rscarson14/CaRe-Monitor/README.md

CaRe-Monitor
============

Resource repository for Infant Cardiac Respiratory Monitor - CaRe Monitor
