rscarson14/CaRe-Monitor/CaRe Electrical Design/Bill of Materials/CaReBOM_DIGIKEY_6.29.xls

Digi-Key Part Number | Manufacturer | Manufacturer Part Number | Customer Reference | Quantity 1 | Quantity 2 | Quantity 3 | Mfg Std Lead Time | Description | Comments | RoHS Status | Lead Free Status | REACH Status
XC1925-ND | ECS INC | ECS-160-20-4X-DU | Y1 | 1 | 0 | 0 | 9 Weeks | CRYSTAL 16MHZ 20PF THRU |  | RoHS Compliant | Lead free | Not Available
MF-MSMF050-2CT-ND | BOURNS INC (VA) | MF-MSMF050-2 | F1 | 1 | 0 | 0 | 9 Weeks | PTC RESETTABLE .50A 15V 1812 | Alternate Packaging Exists | RoHS Compliant | Lead free | Unaffected Dec-2013
296-11981-1-ND | TEXAS INSTRUMENTS (VA) | TLV274IDR | U1, U3 | 2 | 0 | 0 | 7 Weeks | IC OPAMP GP 3MHZ RRO 14SOIC | Alternate Packaging Exists | RoHS Compliant | Lead free | Unaffected Jun-2012
X9C503SIZ-ND | INTERSIL | X9C503SIZ | U2 | 1 | 0 | 0 | 7 Weeks | IC XDCP 100-TAP 50K EE 8-SOIC | Alternate Packaging Exists | RoHS Compliant | Lead free | Unaffected Jun-2012
LT1920CS8#PBF-ND | LINEAR TECHNOLOGY | LT1920CS8#PBF | U5 | 1 | 0 | 0 | 4 Weeks | IC OPAMP INSTR 1MHZ 8SO | Alternate Packaging Exists | RoHS Compliant | Lead free | Unaffected Dec-2013
ATMEGA328-PU-ND | ATMEL | ATMEGA328-PU | U6 | 1 | 0 | 0 | 6 Weeks | IC MCU 8BIT 32KB FLASH 28DIP | No delivery date available | RoHS Compliant | Lead free | Unaffected Jun-2013
MCP73831T-2ACI/OTCT-ND | MICROCHIP TECHNOLOGY (VA) | MCP73831T-2ACI/OT | U7 | 1 | 0 | 0 | 14 Weeks | IC CONTROLLR LI-ION 4.2V SOT23-5 | Alternate Packaging Exists | RoHS Compliant | Lead free | Unaffected Dec-2013
296-27017-1-ND | TEXAS INSTRUMENTS (VA) | TPS61200DRCR | U8 | 1 | 0 | 0 | 11 Weeks | IC REG BOOST SYNC ADJ 1.2A 10SON | Alternate Packaging Exists | RoHS Compliant | Lead free | Unaffected Jun-2012
768-1007-1-ND | FTDI (VA) | FT232RL-REEL | U9 | 1 | 0 | 0 | 10 Weeks | IC USB FS SERIAL UART 28-SSOP | Alternate Packaging Exists | RoHS Compliant | Lead free | Unaffected Jun-2011
160-1427-1-ND | LITE-ON INC (VA) | LTST-C171KRKT | DS1 | 1 | 0 | 0 | 8-10 Weeks | LED SUPER RED CLR THIN 0805 SMD | Alternate Packaging Exists | RoHS Compliant | Lead free | Not Available
LM4040EIM3-2.5/NOPBCT-ND | TEXAS INSTRUMENTS (VA) | LM4040EIM3-2.5/NOPB | U4 | 1 | 0 | 0 | 9 Weeks | IC VREF SHUNT 2.5V SOT23-3 | Alternate Packaging Exists | RoHS Compliant | Lead free | Unaffected Jun-2012
BAT42XV2CT-ND | FAIRCHILD SEMICONDUCTOR (VA) | BAT42XV2 | D1, D2, D3 | 3 | 0 | 0 | 11 Weeks | DIODE SCHOTTKY 30V 0.2A SOD523F | Alternate Packaging Exists | RoHS Compliant | Lead free | Unaffected Jun-2011
GH7268-ND | GRAYHILL INC | 30-100 | S1(MONITOR_EN) | 1 | 0 | 0 | 8 Weeks | SWITCH PUSH SPST-NO 0.15A 24V |  | RoHS Compliant | Lead free | Unaffected Jun-2012
CP-2940-ND | CUI INC | MD-40PL100 | BOX DIN RECEPTACLE, GARMENT DIN RECEPTACLE | 2 | 0 | 0 | 14 Weeks | CONN MINI DIN RECPT 4P PNL MT |  | RoHS Compliant | Lead free | Unaffected Oct-2010
MUSBB15134-ND | AMPHENOL COMMERCIAL PRODUCTS | MUSBB15134 | MINI USB B RECEPTACLE | 1 | 0 | 0 | 6 Weeks | CONN RUGGED USB RCPT R/A MINI B |  | RoHS Compliant | Lead free | Unaffected Nov-2011
SRA27G-ND | SERPAC | A27,GY | BOX | 1 | 0 | 0 | 2 Weeks | BOX A SERIES GRY (3.35X5.3X1.5) |  | RoHS Compliant | Lead free | Unaffected Oct-2011
EG1859-ND | E-SWITCH | R1966ABLKBLKESGRN | SW2 | 1 | 0 | 0 | 12 Weeks | SWITCH ROCKER SPST 15A 125V |  | RoHS Compliant | Lead free | Unaffected Jun-2012
RNCP0805FTD499RCT-ND | STACKPOLE ELECTRONICS INC (VA) | RNCP0805FTD499R | R4 | 1 | 0 | 0 | 10 Weeks | RES 499 OHM 1/4W 1% 0805 | Alternate Packaging Exists | RoHS Compliant | Lead free | Unaffected Aug-2011
RMCF0805FT560KCT-ND | STACKPOLE ELECTRONICS INC (VA) | RMCF0805FT560K | R8 | 1 | 0 | 0 | 9 Weeks | RES 560K OHM 1/8W 1% 0805 | Alternate Packaging Exists | RoHS Compliant | Lead free | Unaffected Aug-2011
RMCF0805FT15K0CT-ND | STACKPOLE ELECTRONICS INC (VA) | RMCF0805FT15K0 | R14 | 1 | 0 | 0 | 9 Weeks | RES 15K OHM 1/8W 1% 0805 | Alternate Packaging Exists | RoHS Compliant | Lead free | Unaffected Aug-2011
311-2.20KCRCT-ND | YAGEO (VA) | RC0805FR-072K2L | R3 | 1 | 0 | 0 | 17 Weeks | RES 2.2K OHM 1/8W 1% 0805 SMD | Alternate Packaging Exists | RoHS Compliant | Lead free | Unaffected Sep-2011
RMCF0805FT2K70CT-ND | STACKPOLE ELECTRONICS INC (VA) | RMCF0805FT2K70 | R1 | 1 | 0 | 0 | 9 Weeks | RES 2.7K OHM 1/8W 1% 0805 | Alternate Packaging Exists | RoHS Compliant | Lead free | Unaffected Aug-2011
RMCF0805FT24K0CT-ND | STACKPOLE ELECTRONICS INC (VA) | RMCF0805FT24K0 | R5 | 1 | 0 | 0 | 9 Weeks | RES 24K OHM 1/8W 1% 0805 | Alternate Packaging Exists | RoHS Compliant | Lead free | Unaffected Aug-2011
RMCF0805FT27K0CT-ND | STACKPOLE ELECTRONICS INC (VA) | RMCF0805FT27K0 | R6 | 1 | 0 | 0 | 9 Weeks | RES 27K OHM 1/8W 1% 0805 | Alternate Packaging Exists | RoHS Compliant | Lead free | Unaffected Aug-2011
RMCF0805FT2K00CT-ND | STACKPOLE ELECTRONICS INC (VA) | RMCF0805FT2K00 | R17 | 1 | 0 | 0 | 9 Weeks | RES 2K OHM 1/8W 1% 0805 | Alternate Packaging Exists | RoHS Compliant | Lead free | Unaffected Aug-2011
RMCF0805FT374KCT-ND | STACKPOLE ELECTRONICS INC (VA) | RMCF0805FT374K | R13 | 1 | 0 | 0 | 9 Weeks | RES 374K OHM 1/8W 1% 0805 | Alternate Packaging Exists | RoHS Compliant | Lead free | Unaffected Aug-2011
RMCF0805FT2M00CT-ND | STACKPOLE ELECTRONICS INC (VA) | RMCF0805FT2M00 | R18, R19 | 2 | 0 | 0 | 9 Weeks | RES 2M OHM 1/8W 1% 0805 | Alternate Packaging Exists | RoHS Compliant | Lead free | Unaffected Aug-2011
311-470CRCT-ND | YAGEO (VA) | RC0805FR-07470RL | R16, R22, R26 | 3 | 0 | 0 | 17 Weeks | RES 470 OHM 1/8W 1% 0805 SMD | Alternate Packaging Exists | RoHS Compliant | Lead free | Unaffected Sep-2011
RMCF0805FT560RCT-ND | STACKPOLE ELECTRONICS INC (VA) | RMCF0805FT560R | R7, R9, R12 | 3 | 0 | 0 | 9 Weeks | RES 560 OHM 1/8W 1% 0805 | Alternate Packaging Exists | RoHS Compliant | Lead free | Unaffected Aug-2011
RMCF0805FT220KCT-ND | STACKPOLE ELECTRONICS INC (VA) | RMCF0805FT220K | R10, R11, G20, R21 | 4 | 0 | 0 | 9 Weeks | RES 220K OHM 1/8W 1% 0805 | Alternate Packaging Exists | RoHS Compliant | Lead free | Unaffected Aug-2011
RMCF0805FT10K0CT-ND | STACKPOLE ELECTRONICS INC (VA) | RMCF0805FT10K0 | R2, R15, R23, R24, R25 | 5 | 0 | 0 | 9 Weeks | RES 10K OHM 1/8W 1% 0805 | Alternate Packaging Exists | RoHS Compliant | Lead free | Unaffected Aug-2011
445-7665-1-ND | TDK CORPORATION (VA) | C2012X5R1A226M125AB | C24 | 1 | 0 | 0 | 12 Weeks | CAP CER 22UF 10V 20% X5R 0805 | Alternate Packaging Exists | RoHS Compliant | Lead free | Unaffected Apr-2011
720-1074-1-ND | VISHAY VITRAMON (VA) | VJ0805A470JXGAT5Z | C3 | 1 | 0 | 0 | 12 Weeks | CAP CER 47PF 1KV 5% NP0 0805 | Alternate Packaging Exists | RoHS Compliant | Lead free | Unaffected Dec-2011
399-1113-1-ND | KEMET (VA) | C0805C220J5GACTU | C15, C19 | 2 | 0 | 0 | 16 Weeks | CAP CER 22PF 50V 5% NP0 0805 | Alternate Packaging Exists | RoHS Compliant | Lead free | Unaffected Jun-2012
490-4522-1-ND | MURATA ELECTRONICS (VA) | GRM21BR71C475KA73L | C14, C17 | 2 | 0 | 0 | 18 Weeks | CAP CER 4.7UF 16V 10% X7R 0805 | Alternate Packaging Exists | RoHS Compliant | Lead free | Unaffected Jul-2011
490-5523-1-ND | MURATA ELECTRONICS (VA) | GRM21BR61E106KA73L | C6, C7, C11 | 3 | 0 | 0 | 18 Weeks | CAP CER 10UF 25V 10% X5R 0805 | Alternate Packaging Exists | RoHS Compliant | Lead free | Unaffected Jul-2011
478-3281-1-ND | AVX CORPORATION (VA) | TAJP106M010RNJ | C9, C13, C16, C22, C23 | 5 | 0 | 0 | 13 Weeks | CAP TANT 10UF 10V 20% 0805 | Alternate Packaging Exists | RoHS Compliant | Lead free | Unaffected Jun-2012
490-1664-1-ND | MURATA ELECTRONICS (VA) | GRM216R71H103KA01D | C1, C2, C5, C10 | 4 | 0 | 0 | 18 Weeks | CAP CER 10000PF 50V 10% X7R 0805 | Alternate Packaging Exists | RoHS Compliant | Lead free | Unaffected Jul-2011
478-1395-1-ND | AVX CORPORATION (VA) | 08055C104KAT2A | C4, C8, C12, C18, C20, C21, C25 | 7 | 0 | 0 | 13 Weeks | CAP CER 0.1UF 50V 10% X7R 0805 | No delivery date available | RoHS Compliant | Lead free | Unaffected Jun-2012
308-1947-1-ND | SUMIDA AMERICA COMPONENTS INC (VA) | CDRH2D09NP-4R7MC | L1 | 1 | 0 | 0 | 13 Weeks | INDUCTOR 4.7UH 25% SMD | Alternate Packaging Exists | RoHS Compliant | Lead free | Not Available
NDS0605CT-ND | FAIRCHILD SEMICONDUCTOR (VA) | NDS0605 | Q1 | 1 | 0 | 0 | 7 Weeks | MOSFET P-CH 60V 180MA SOT-23 | Alternate Packaging Exists | RoHS Compliant | Lead free | Unaffected Jun-2011
455-1790-1-ND | JST SALES AMERICA INC (VA) | BM04B-SRSS-TB(LF)(SN) | P2(USB), P6(ELECTRODES) | 2 | 0 | 0 | 12-14 Weeks | CONN HEADER SH 4POS TOP 1MM TIN | Alternate Packaging Exists | RoHS Compliant | Lead free | N/A
455-1793-1-ND | JST SALES AMERICA INC (VA) | BM07B-SRSS-TB(LF)(SN) | P7(FRNT_PNL) | 1 | 0 | 0 | 12-14 Weeks | CONN HEADER SH 7POS TOP 1MM TIN | Alternate Packaging Exists | RoHS Compliant | Lead free | N/A
455-1791-1-ND | JST SALES AMERICA INC (VA) | BM05B-SRSS-TB(LF)(SN) | P5(TOP_PNL) | 1 | 0 | 0 | 12-14 Weeks | CONN HEADER SH 5POS TOP 1MM TIN | Alternate Packaging Exists | RoHS Compliant | Lead free | N/A
455-1749-1-ND | JST SALES AMERICA INC (VA) | S2B-PH-SM4-TB(LF)(SN) | LS1(ALARM), P4(BAT) | 2 | 0 | 0 | 12-14 Weeks | CONN HEADER PH SIDE 2POS 2MM SMD | Alternate Packaging Exists | RoHS Compliant | Lead free | N/A
952-2121-ND | HARWIN INC | M20-9980346 | P1(ICSP) | 1 | 0 | 0 | 8 Weeks | DIL VERTICAL PC TAIL PIN HEADER |  | RoHS Compliant | Lead free | Unaffected Dec-2013
668-1049-ND | PUI AUDIO, INC. | AI-4228-TF-LW140-3-R | LS1(ALARM BUZZER) | 1 | 0 | 0 | 11 Weeks | BUZZER PIEZO 12VDC 42MM PANEL |  | RoHS Compliant | Lead free | Unaffected Aug-2011
67-1400-ND | LUMEX OPTO/COMPONENTS INC | SSL-LX100133XGC | D6(GREEN) | 1 | 0 | 0 | 12 Weeks | LED 10MM MEGA-BRITE GREEN CLEAR |  | RoHS Compliant | Lead free | Unaffected Jun-2013
67-1399-ND | LUMEX OPTO/COMPONENTS INC | SSL-LX100133X0C | D4, D5 | 2 | 0 | 0 | 12 Weeks | LED 10MM MEGA-BRITE ORNG/RED CLR |  | RoHS Compliant | Lead free | Unaffected Jun-2013
455-1397-ND | JST SALES AMERICA INC | SHR-07V-S | P7(HOUSING) | 1 | 0 | 0 | 12-14 Weeks | CONN HOUSING SH 7POS 1MM WHITE |  | RoHS Compliant | Lead free | N/A
455-1379-ND | JST SALES AMERICA INC | SHR-04V-S-B | P2(USB HOUSING), P6(ELECTRODES HOUSING) | 2 | 0 | 0 | 12-14 Weeks | CONN HOUSING SH 4POS 1MM WHITE |  | RoHS Compliant | Lead free | N/A
455-1377-ND | JST SALES AMERICA INC | SHR-02V-S-B | LS1(HOUSING), P4(HOUSING) | 2 | 0 | 0 | 12-14 Weeks | CONN HOUSING SH 2POS 1MM WHITE |  | RoHS Compliant | Lead free | N/A
