rscarson14/CaRe-Monitor/CaRe Electrical Design/Electrical Testing/Test Point Standards.docx

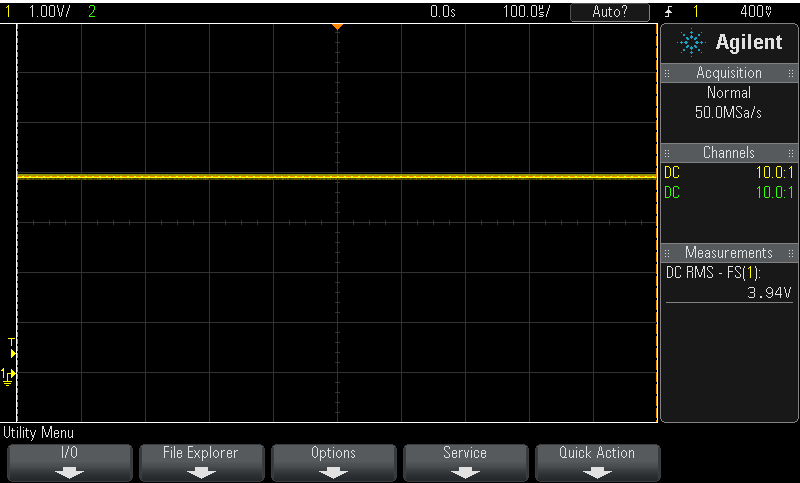
[picture p1: figure]

TP1 | Net Label: | VBAT
| Measurement: | 3.6-4.2 Volts
| Comment: | This line is connected to the positive terminal on the LiPo Battery. When fully charged, the battery voltage should be above 4V. It operates at 3.6-4.2V. Below 3.6V is a low battery and should be charged.

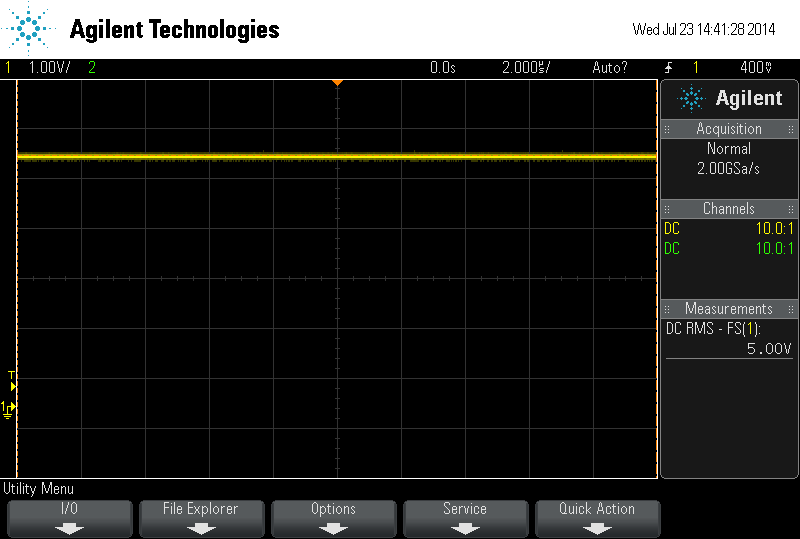
[picture p2: figure]

TP2 | Net Label: | VCC
| Measurement: | ~5.0 Volts
| Comment: | Boosted supply voltage to the board BEFORE the ON/OFF switch

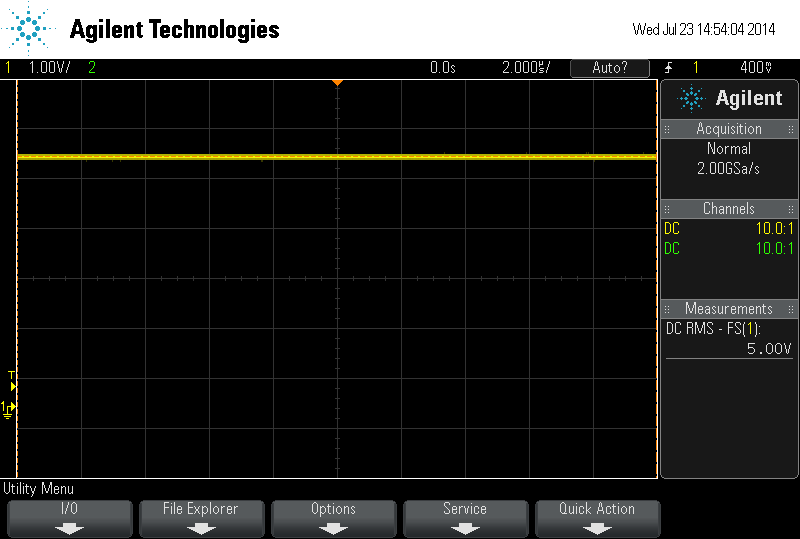
[picture p3: figure]

TP3 | Net Label | +5V
| Measurement: | ~0.0 volts with switch turned OFF ~5.0 Volts with switch turned ON (same as TP2)
| Comment: | With switch turned ON, +5V supply here. ~0.0 volts with switch turned OFF

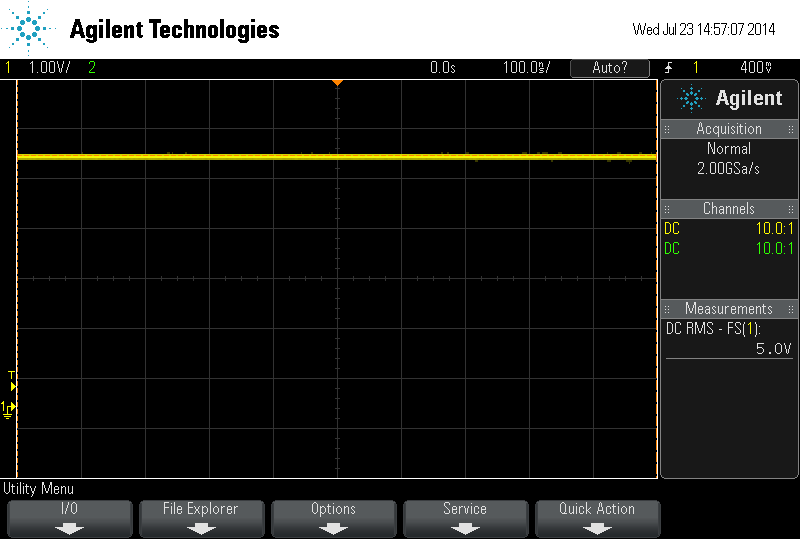
[picture p4: figure]

TP4 | Net Label | AVS
| Measurement: | ~0.0 Volts when monitor not active ~ 5.0 Volts when monitor is active
| Comment: | Analog Front End voltage supply. This is supplied only after the pushbutton on the front panel has been pressed and the monitor becomes active.

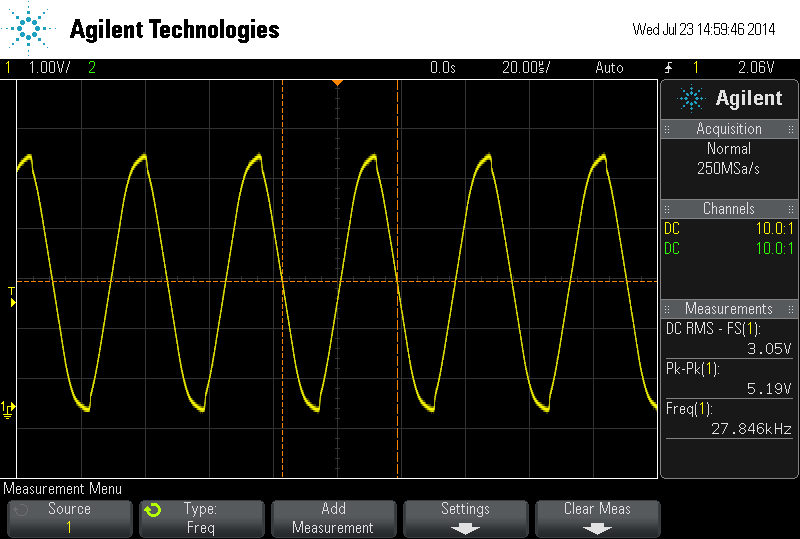
[picture p5: figure]

TP5 | Net Label | VCARRIER
| Measurement: | ~5.0 Volts Pk-Pk ~ 30 KHz +/- 10%
| Comment: | Carrier signal for impedance pneumography. Patient electrode #1

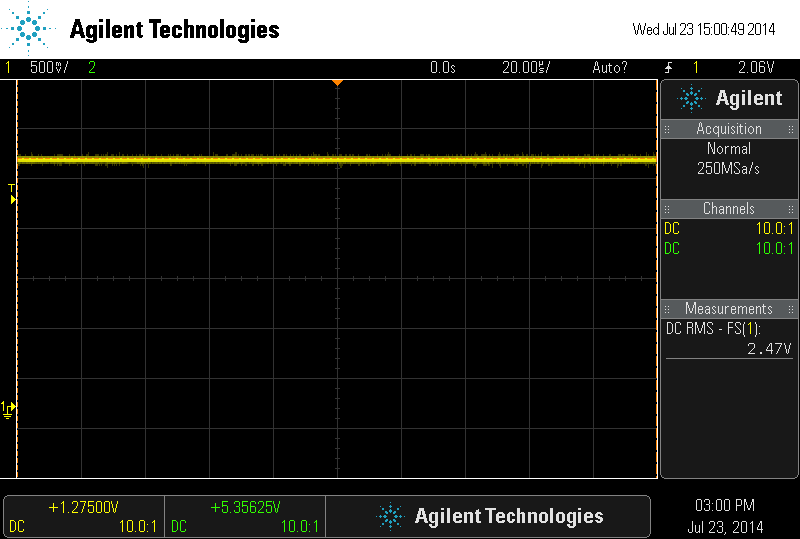
[picture p6: figure]

TP6 | Net Label | VREF
| Measurement: | ~2.5 Volts
| Comment: | Reference for analog front end. Patient Electrode #4

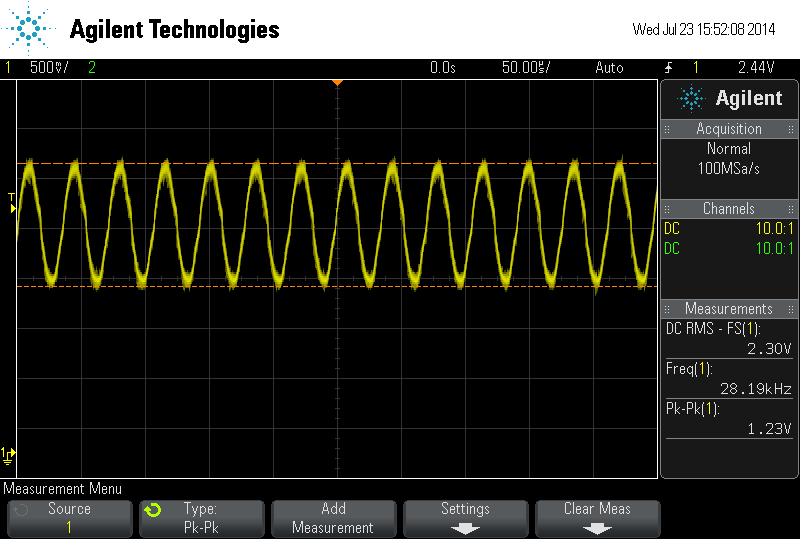
[picture p7: figure]

TP7 | Net Label | GAINFBK
| Measurement: | ~ 30 KHz +/- 10% (same frequency as TP5)
| Comment: | This signal may only be present if the electrode belt is plugged in and currently being worn by a patient. The voltage amplitude will vary from patient to patient.

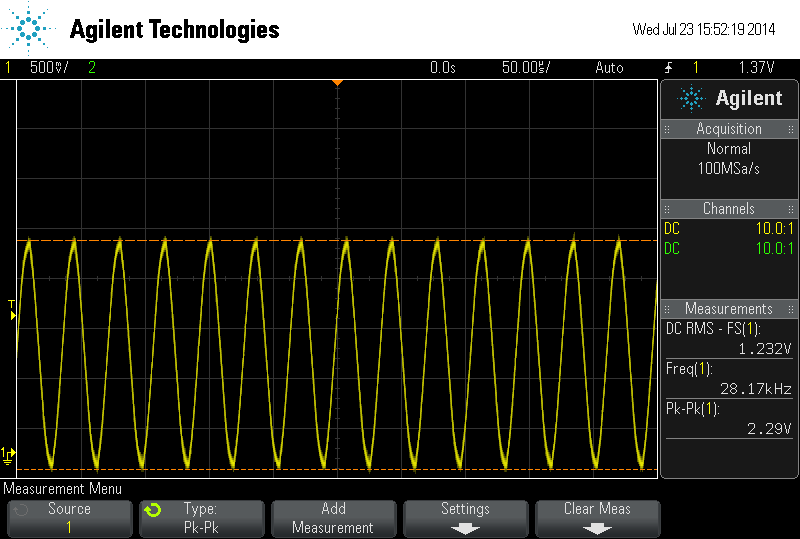
[picture p8: figure]

TP8 | Net Label | VRIGHT
| Measurement: | ~ 30 KHz +/- 10% (same frequency as TP5)
| Comment: | This signal may only be present if the electrode belt is plugged in and currently being worn by a patient. The voltage amplitude will vary from patient to patient.

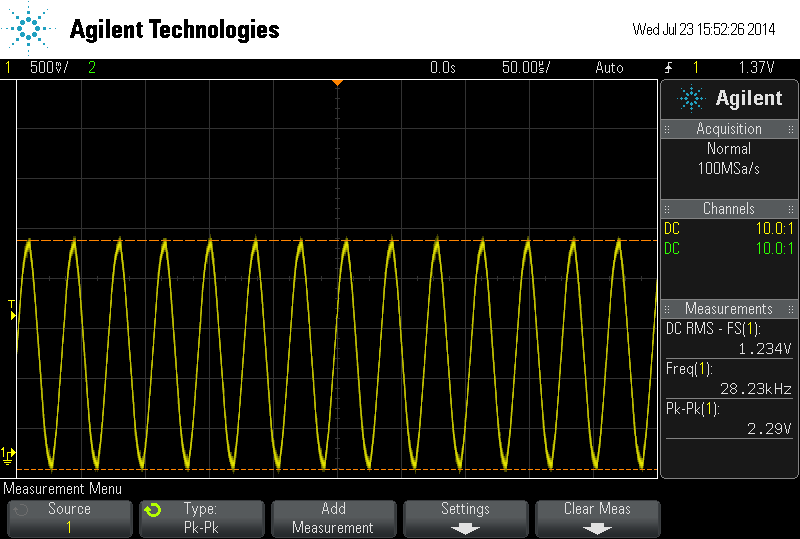
[picture p9: figure]

TP9 | Net Label | VLEFT
| Measurement: | ~ 30 KHz
| Comment: | This signal may only be present if the electrode belt is plugged in and currently being worn by a patient. The voltage amplitude will vary from patient to patient.

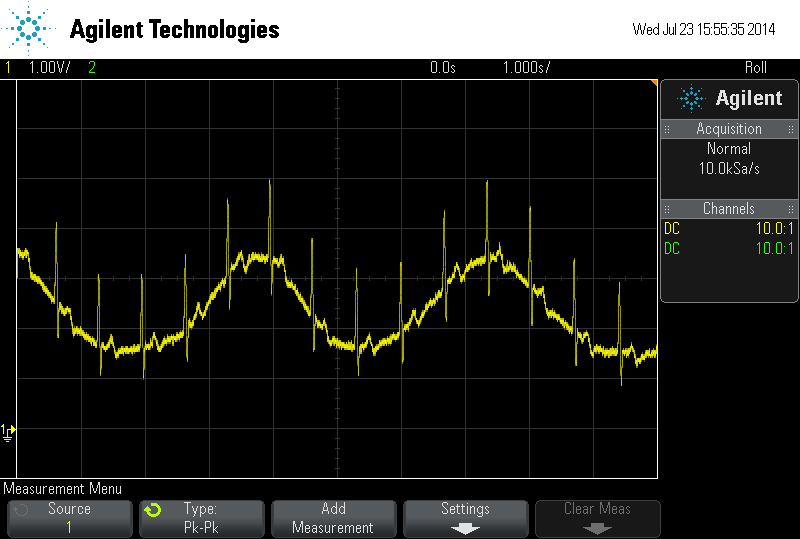
[picture p10: figure]

TP10 | Net Label | VSIG
| Measurement: | 0.0 – 5.0 Volts
| Comment: | This is the signal of interest measured by the ADC on the Microcontroller
