rscarson14/CaRe-Monitor/CaRe Electrical Design/Circuit Schematic Documents/CareBoard_SMD.pdf

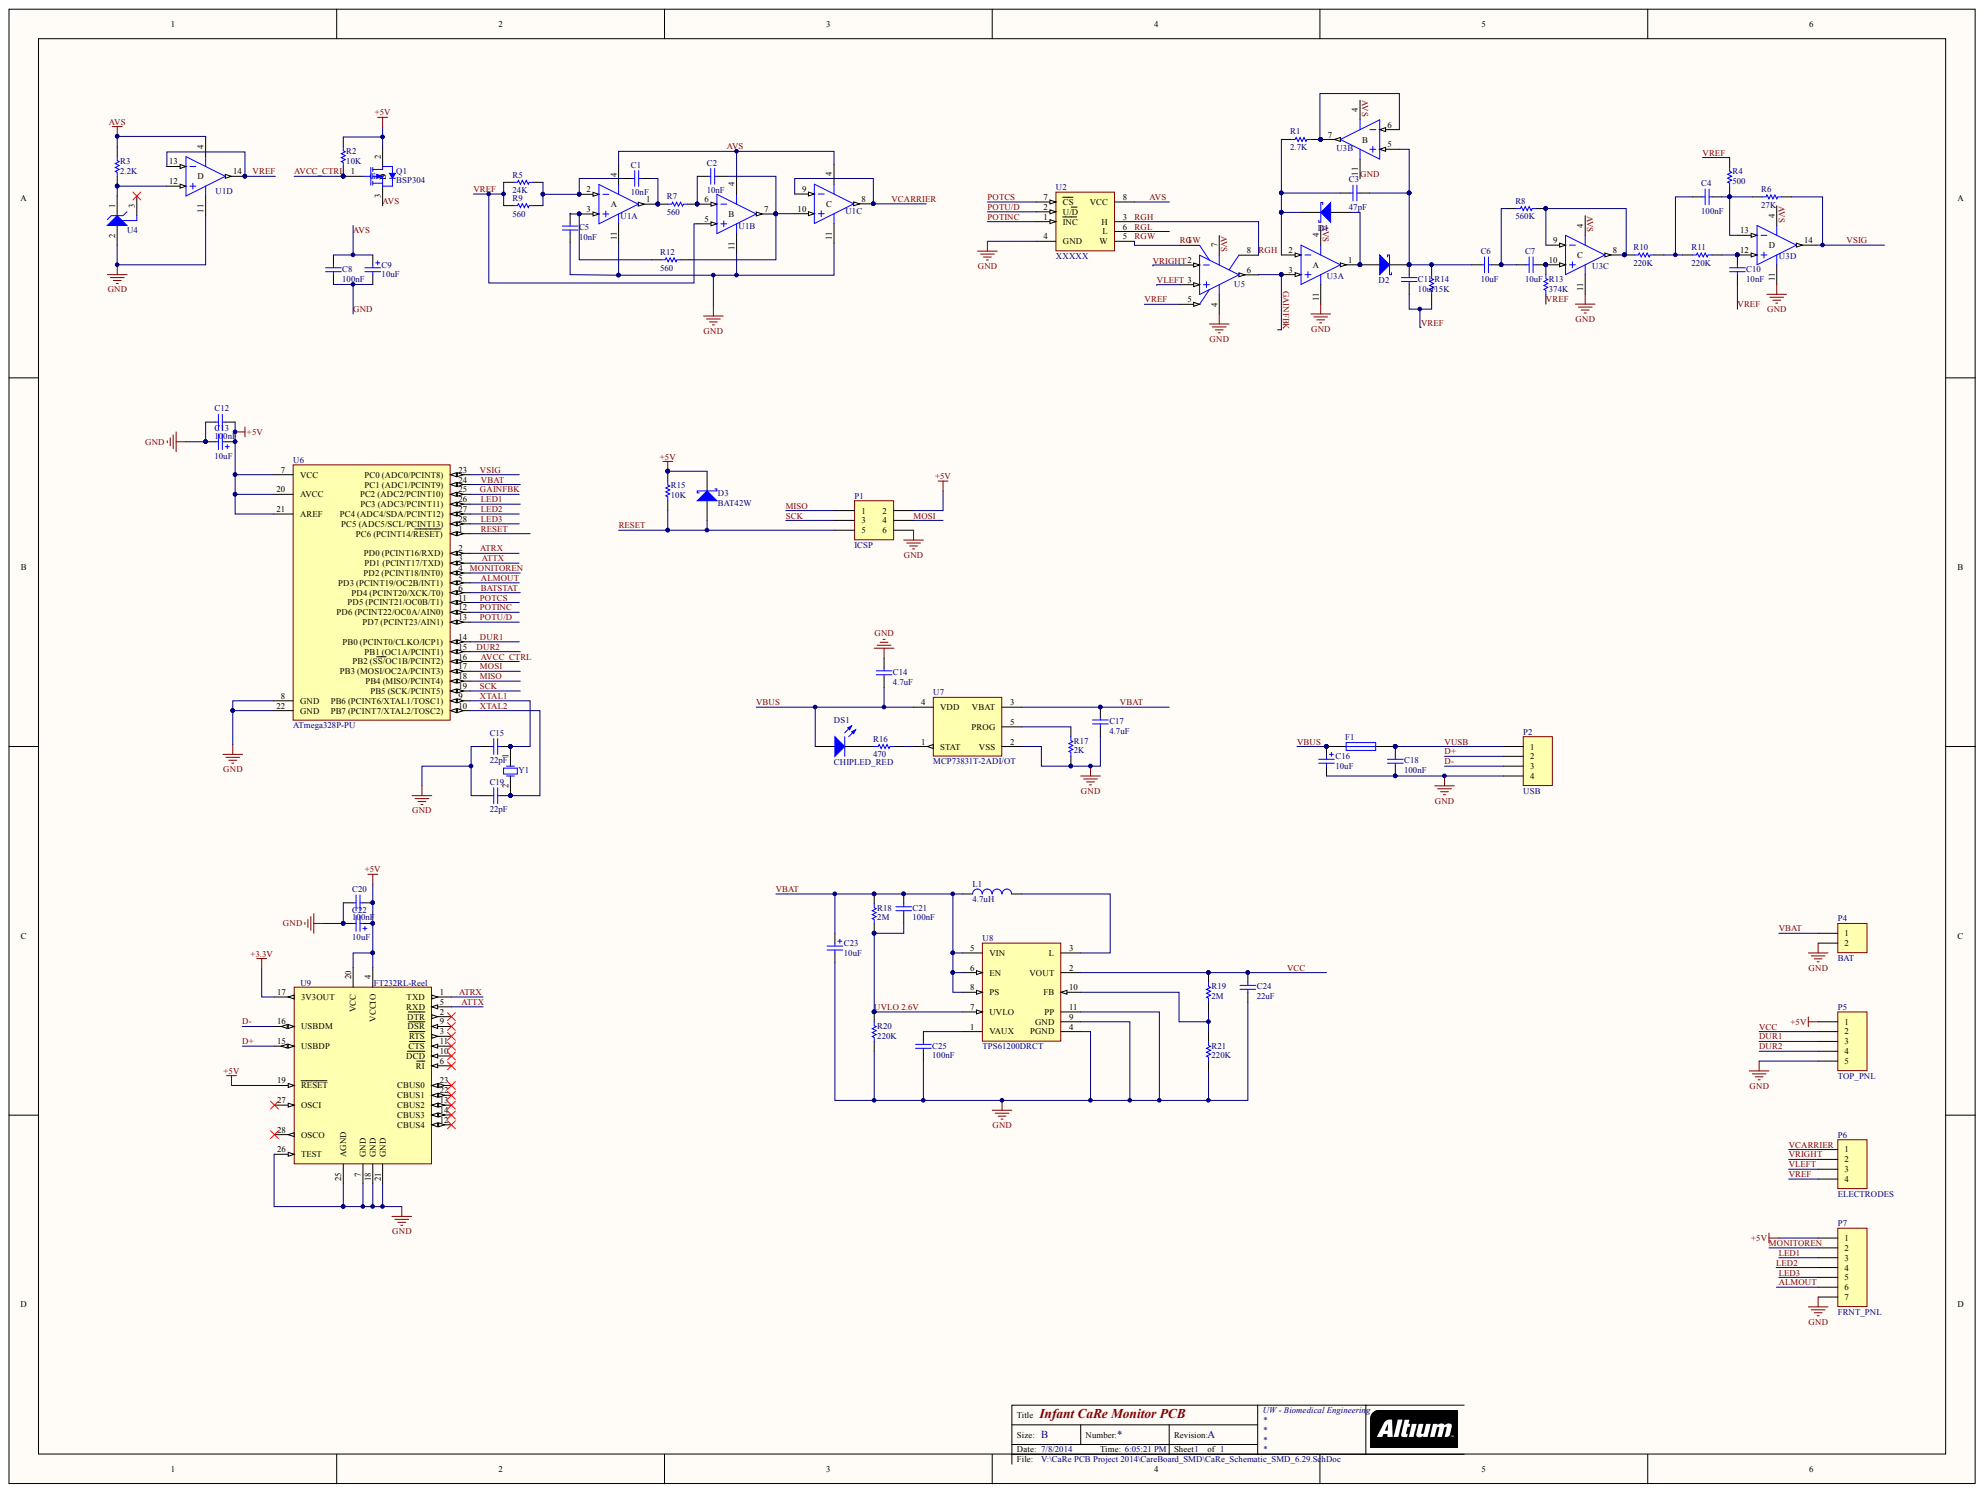
[picture p11: page 1]

Infant CaRe Monitor PCB Title | UW - Biomedical Engineering * * * *

Size: B | Number: * | Revision: A

Date: 7/8/2014 Time: 6:05:21 PM | | Sheet 1 of 1
File: V:\CaRe PCB Project 2014\CareBoard_SMD\CaRe_Schematic_SMD_6.29.SchDoc

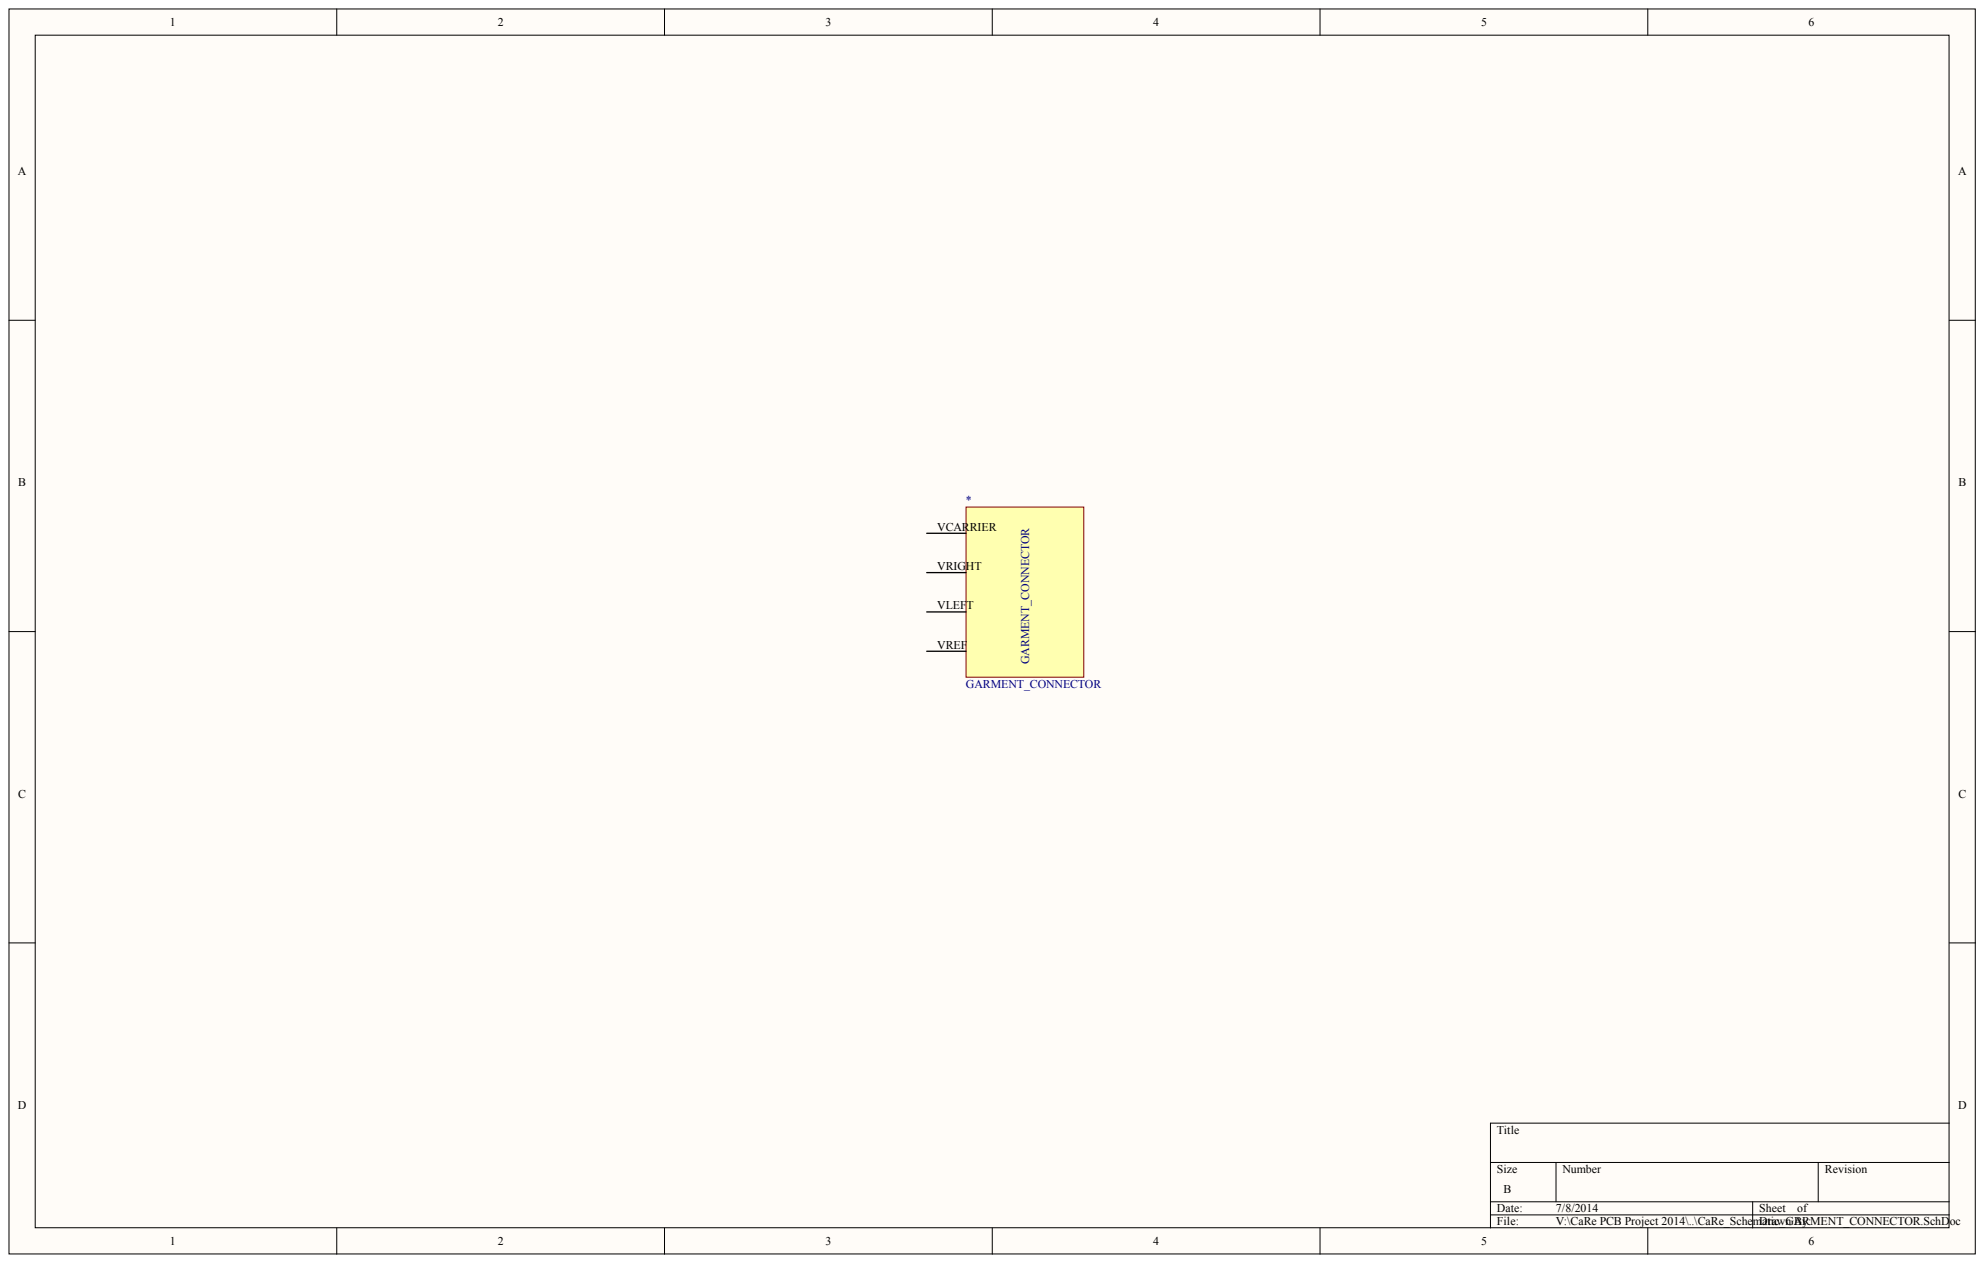
[picture p12: page 2]

Size B | Number | Revision

Date: 7/8/2014 | Sheet of

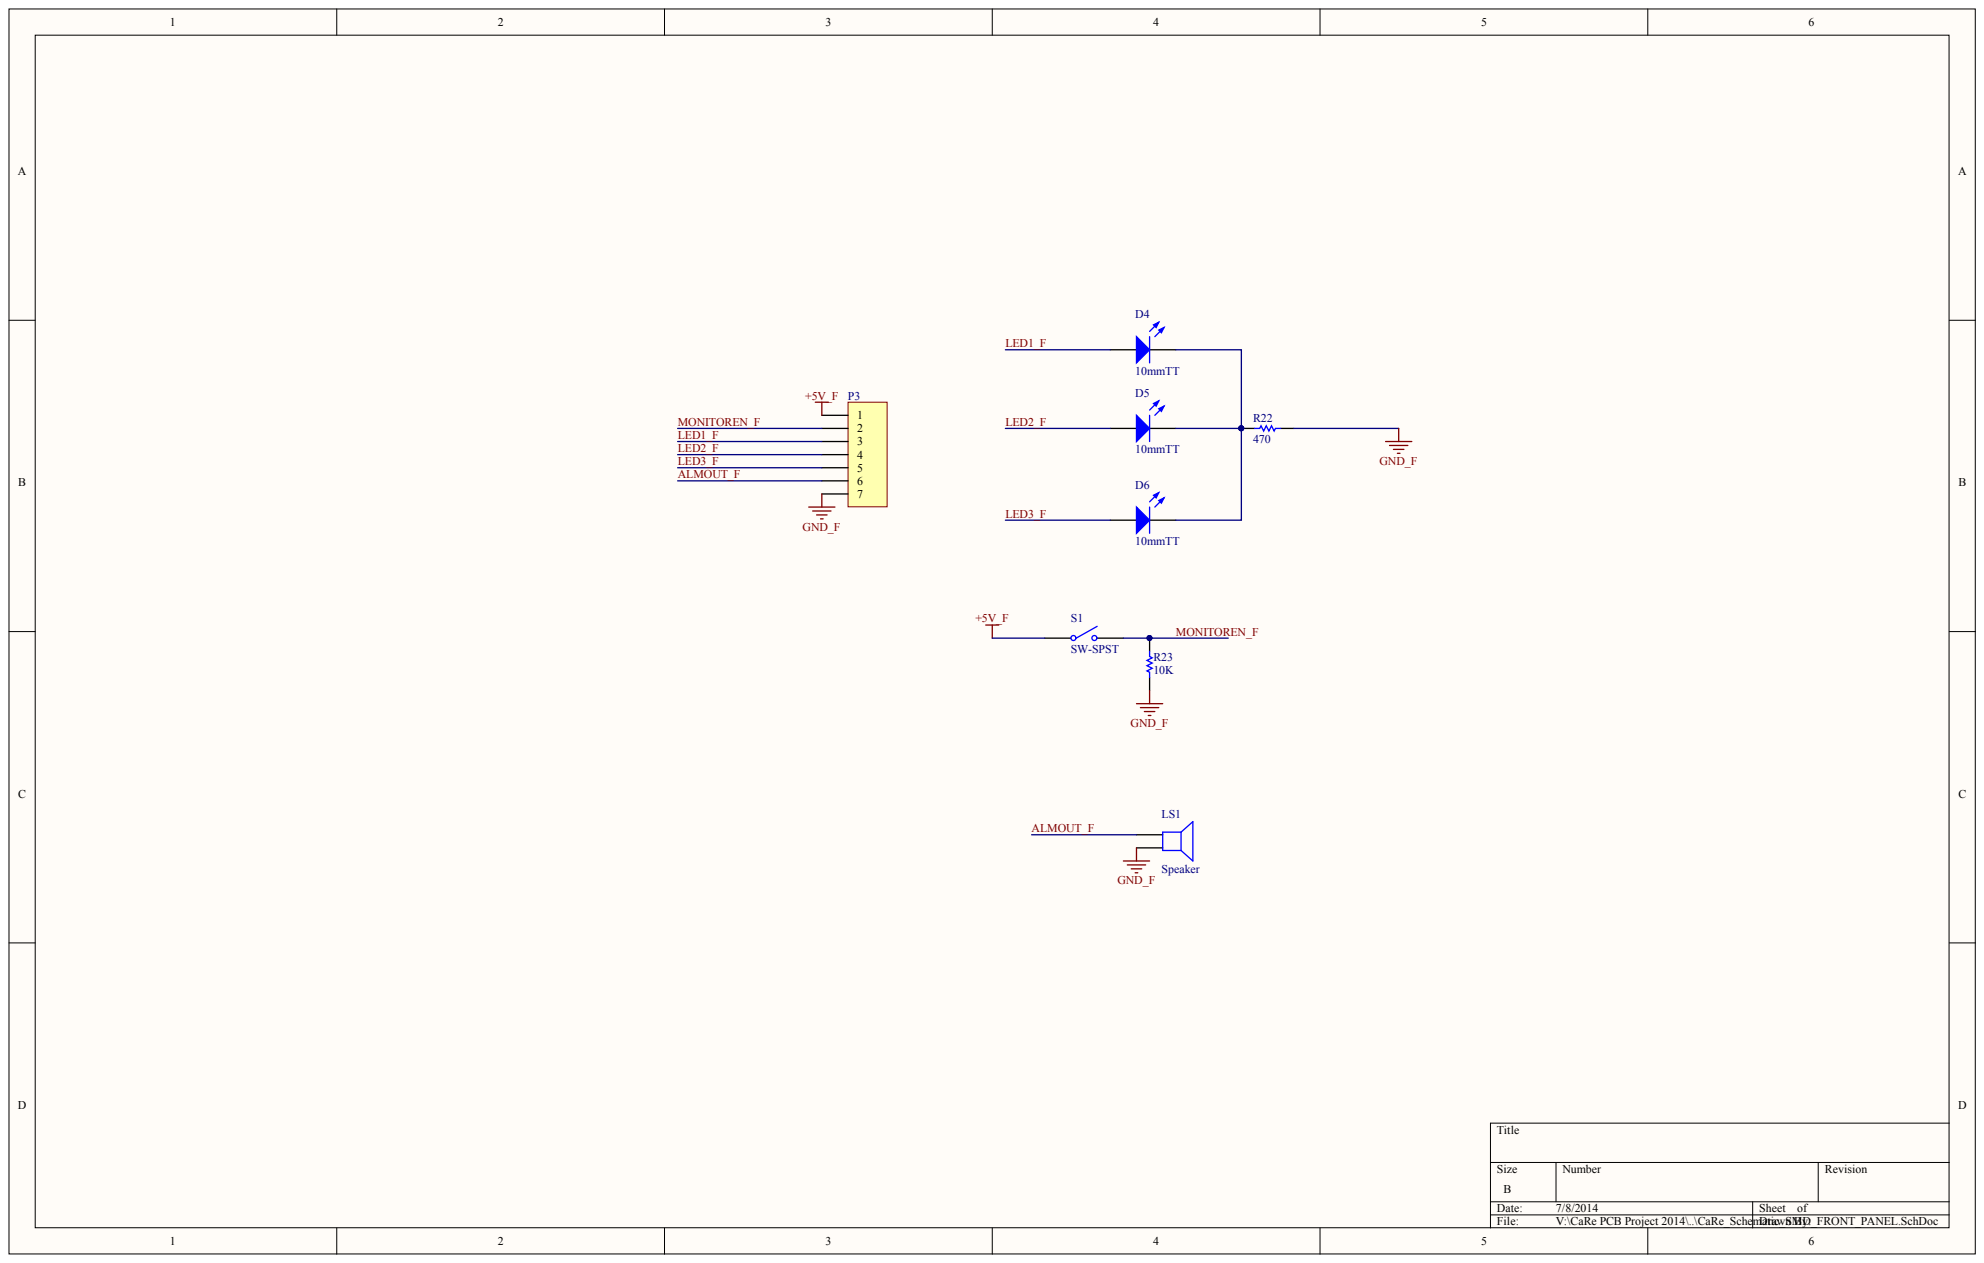
[picture p13: page 3]

Size B | Number | Revision

Date: 7/8/2014 | Sheet of
File: V:\CaRe PCB Project 2014\..\CaRe_SchemDatrawic_SMD n By:_FRONT_PANEL.SchDoc

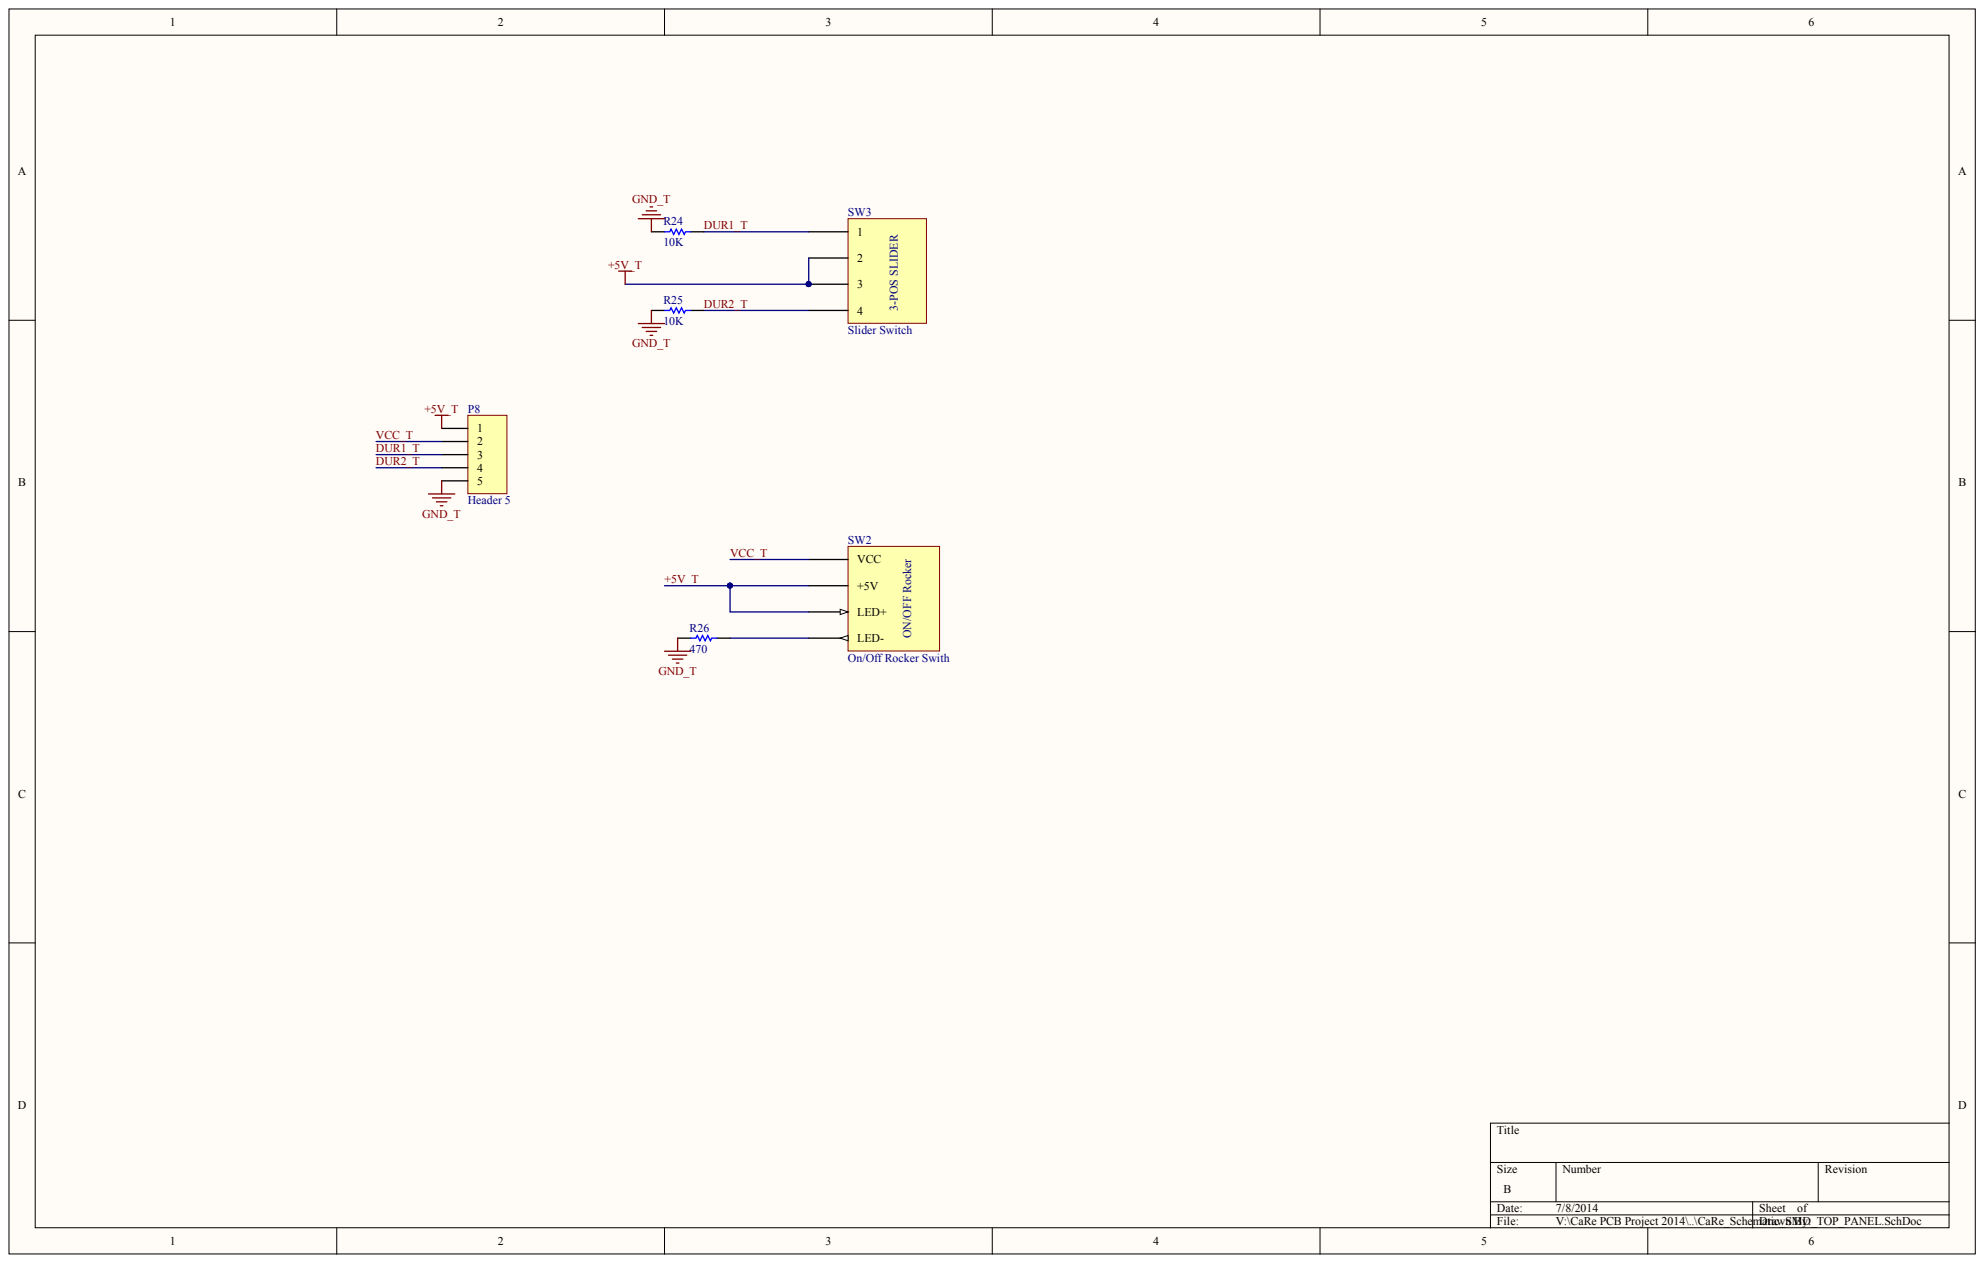
[picture p14: page 4]

LED-
On/Off Rocker Swith

Size B | Number | Revision

Date: 7/8/2014 | Sheet of
File: V:\CaRe PCB Project 2014\..\CaRe_SchemDatrawic_SMD n By:_TOP_PANEL.SchDoc

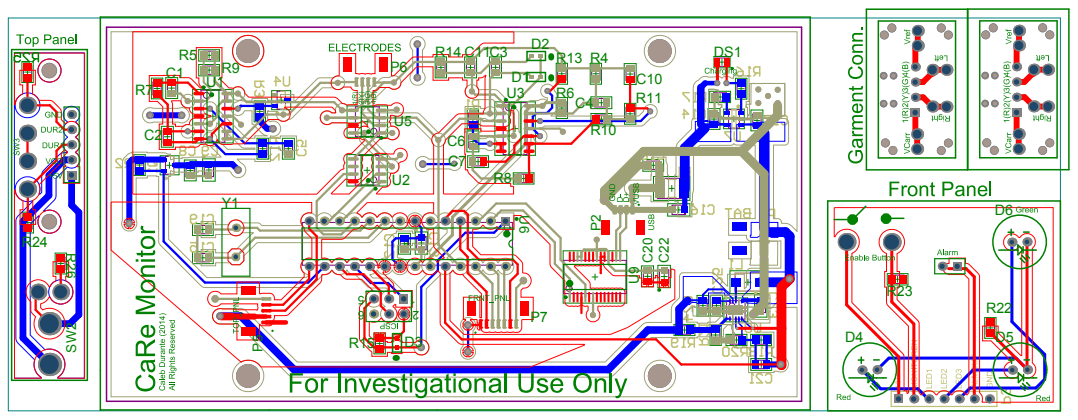
[picture p15: page 5]
