rscarson14/CaRe-Monitor/(list of files, drawings)

Other design files:
CaRe Electrical Design/Altium Design Files/CareBoard_SMD/Backups/CaRe_PCBLib.~(1).PcbLib
CaRe Electrical Design/Altium Design Files/CareBoard_SMD/Backups/CaRe_Schematic_SMD.~(1).SchDoc
CaRe Electrical Design/Altium Design Files/CareBoard_SMD/Backups/CaRe_Schematic_SMD_FRONT_PANEL.~(1).SchDoc
CaRe Electrical Design/Altium Design Files/CareBoard_SMD/Backups/CaRe_Schematic_SMD_TOP_PANEL.~(1).SchDoc
CaRe Electrical Design/Altium Design Files/CareBoard_SMD/Backups/CaRe_SchematicLib.~(1).SchLib
CaRe Electrical Design/Altium Design Files/CareBoard_SMD/Backups/CareBoard_SMD.~(1).PcbDoc
CaRe Electrical Design/Altium Design Files/CareBoard_SMD/Backups/CareBoard_SMD.~(1).PrjPcb
CaRe Electrical Design/Altium Design Files/CareBoard_SMD/Backups/CareBoard_SMD_BEFORE_AUTOROUTER.~(1).PcbDoc
CaRe Electrical Design/Altium Design Files/CareBoard_SMD/CaRe_Schematic_GARMENT_CONNECTOR.SchDoc
CaRe Electrical Design/Altium Design Files/CareBoard_SMD/CaRe_Schematic_SMD.SchDoc
CaRe Electrical Design/Altium Design Files/CareBoard_SMD/CaRe_Schematic_SMD_6.29.SchDoc
CaRe Electrical Design/Altium Design Files/CareBoard_SMD/CaRe_Schematic_SMD_FRONT_PANEL.SchDoc
CaRe Electrical Design/Altium Design Files/CareBoard_SMD/CaRe_Schematic_SMD_KRITIKARE.SchDoc
CaRe Electrical Design/Altium Design Files/CareBoard_SMD/CaRe_Schematic_SMD_TOP_PANEL.SchDoc
CaRe Electrical Design/Altium Design Files/CareBoard_SMD/CareBoard_SMD.PcbDoc
CaRe Electrical Design/Altium Design Files/CareBoard_SMD/CareBoard_SMD.PrjPcb
CaRe Electrical Design/Altium Design Files/CareBoard_SMD/CareBoard_SMD_AUTOROUTER.PcbDoc
CaRe Electrical Design/Altium Design Files/CareBoard_SMD/CareBoard_SMD_BEFORE_AUTOROUTER.PcbDoc
CaRe Electrical Design/Altium Design Files/CareBoard_SMD/CareBoard_SMD_ORDERED_6.29.PcbDoc
CaRe Electrical Design/Altium Design Files/CareBoard_SMD/CareBoard_SMD_ORDERED_JUNE1.PcbDoc
CaRe Electrical Design/Altium Design Files/CareBoard_SMD/CareLib/CaRe_PCBLib.PcbLib
CaRe Electrical Design/Altium Design Files/CareBoard_SMD/CareLib/CaRe_SchematicLib.SchLib
CaRe Electrical Design/Altium Design Files/CareBoard_SMD/History/CareBoard_SMD.~(20).PcbDoc
