rscarson14/CaRe-Monitor/CaRe_source/App/ISR.h

#define _ADC_DATA_BUFFER_
#define _PUSH_BUTTON_
#define _UART_COMMS_
#define _BLINKERS_
#define _MAIN_

#include <avr/io.h>
#include <stdint.h>
#include <avr/interrupt.h>
#include <avr/sleep.h>
#include "Globals.h"
#include "ADC_HAL.h"
#include "Macros.h"

#ifndef ISR_H_
#define ISR_H_





#endif /* ISR_H_ */
